tomwimmenhove/B133D01/base.kicad_pcb

## KiCad design base.kicad_pcb (2019-05-05)

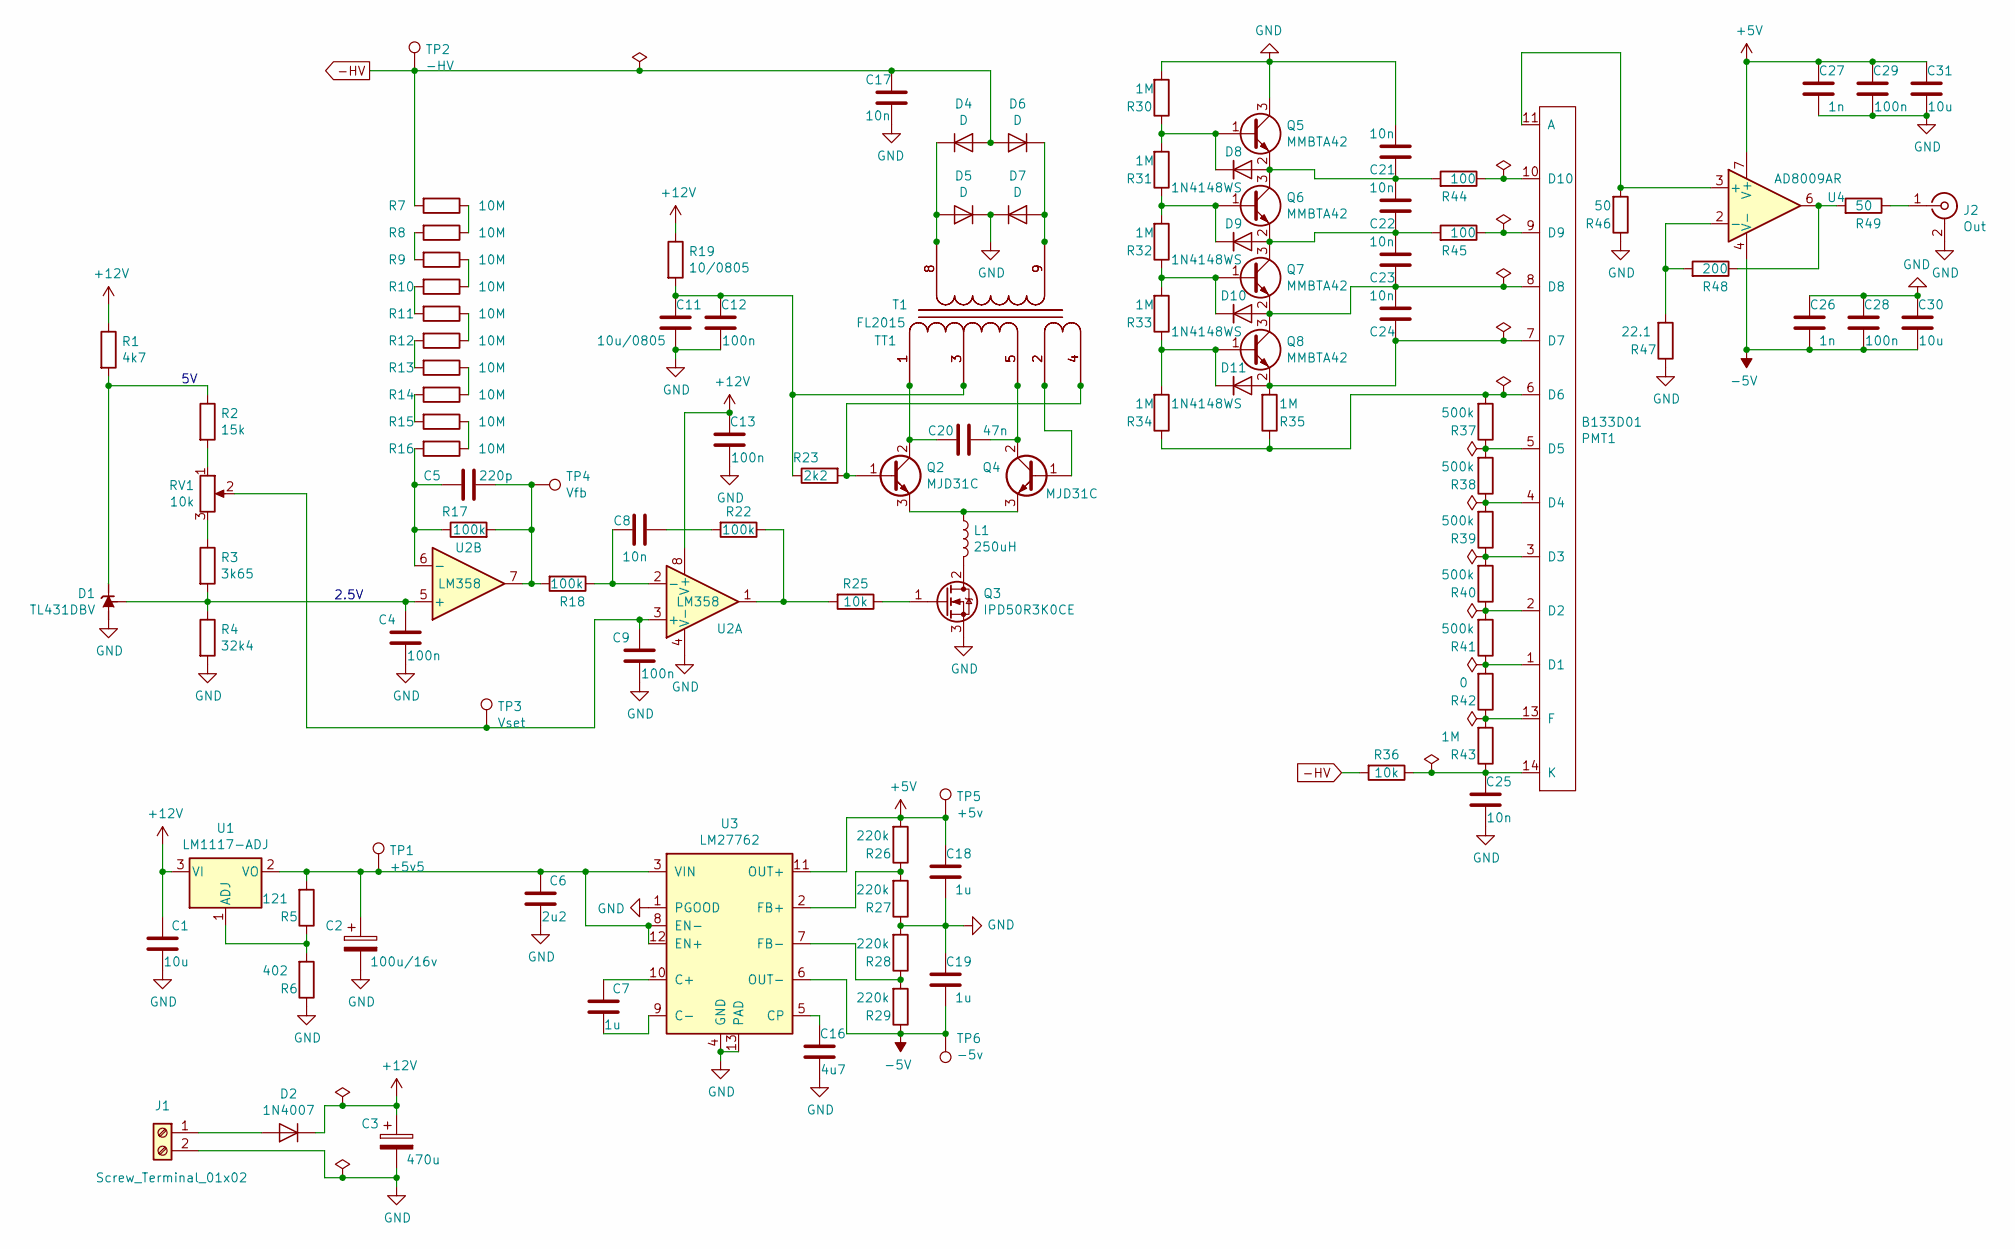
[picture p1: schematic base.sch]

Parts:
C1: 10u; C_0805_2012Metric
C2: 100u/16v; CP_EIA-7343-30_AVX-N
C3: 470u; CP_EIA-7360-38_Kemet-E
C4, C9, C12, C13, C28, C29: 100n; C_0603_1608Metric
C5: 220p; C_0603_1608Metric
C6: 2u2; C_0603_1608Metric
C7, C18, C19: 1u; C_0603_1608Metric
C8: 10n; C_0603_1608Metric
C11: 10u/0805; C_0805_2012Metric
C16: 4u7; C_0603_1608Metric
C17, C25: 10n; C_Disc_D10.5mm_W5.0mm_P7.50mm
C20: 47n; C_Rect_L7.2mm_W3.5mm_P5.00mm_FKS2_FKP2_MKS2_MKP2
C21, C22, C23, C24: 10n; C_0805_2012Metric
C26, C27: 1n; C_0603_1608Metric
C30, C31: 10u; C_0603_1608Metric
D1: TL431DBV; SOT-23-5
D2: 1N4007; D_SMB
D4, D5, D6, D7: D; D_A-405_P12.70mm_Horizontal
D8, D9, D10, D11: 1N4148WS; D_SOD-323
J1: Screw_Terminal_01x02; TerminalBlock_4Ucon_1x02_P3.50mm_Horizontal
J2: Out; SMA_Amphenol_132291-12_Vertical
L1: 250uH; L_Taiyo-Yuden_NR-80xx
PMT1: B133D01
Q2, Q4: MJD31C; TO-252-2
Q3: IPD50R3K0CE; TO-252-2
Q5, Q6, Q7, Q8: MMBTA42; SOT-23
R1: 4k7; R_0603_1608Metric
R2: 15k; R_0603_1608Metric
R3: 3k65; R_0603_1608Metric
R4: 32k4; R_0603_1608Metric
R5: 121; R_0603_1608Metric
R6: 402; R_0603_1608Metric
R7, R8, R9, R10, R11, R12, R13, R14, R15, R16: 10M; R_0805_2012Metric
R17, R18, R22: 100k; R_0603_1608Metric
R19: 10/0805; R_0805_2012Metric
R23: 2k2; R_0805_2012Metric
R25: 10k; R_0603_1608Metric
R26, R27, R28, R29: 220k; R_0603_1608Metric
R30, R31, R32, R33, R34, R35: 1M; R_0805_2012Metric
R36: 10k; R_0805_2012Metric
R37, R38, R39, R40, R41: 500k; R_0805_2012Metric
R42: 0; R_0603_1608Metric
R43: 1M; R_1206_3216Metric
R44, R45: 100; R_0603_1608Metric
R46: 50; R_0603_1608Metric
R47: 22.1; R_0603_1608Metric
R48: 200; R_0603_1608Metric
R49: 50; R_0805_2012Metric
RV1: 10k; Potentiometer_Bourns_3314J_Vertical
T1: FL2015; FL2015-4LB
TP1: +5v5; TestPoint_Pad_D1.5mm
TP2: -HV; TestPoint_Pad_D1.5mm
TP3: Vset; TestPoint_Pad_D1.5mm
TP4: Vfb; TestPoint_Pad_D1.5mm
TP5: +5v; TestPoint_Pad_D1.5mm
TP6: -5v; TestPoint_Pad_D1.5mm
TT1: FL2015; G23736
U1: LM1117-ADJ; SOT-223-3_TabPin2
U2: LM358; SOIC-8_3.9x4.9mm_P1.27mm
U3: LM27762; WSON-12-1EP_3x2mm_P0.5mm_EP1x2.65_ThermalVias
U4: AD8009AR; SOIC-8_3.9x4.9mm_P1.27mm

Connections:
+5V: C18.1, C27.1, C29.1, C31.1, R26.2, TP5.1, U3.11 (OUT+), U4.7 (V+)
+12V: C1.1, C3.1, C13.1, D2.1 (K), R1.1, R19.1, U1.3 (VI), U2.8 (V+)
-5V: C19.2, C26.2, C28.2, C30.2, R29.1, TP6.1, U3.6 (OUT-), U4.4 (V-)
-HV: C17.1, D4.2 (A), D6.2 (A), R7.2, R36.2, TP2.1
GND: C1.2, C2.2, C3.2, C4.2, C6.2, C9.2, C11.2, C12.2, C13.2, C16.2, C17.2, C18.2, C19.1, C21.2, C25.2, C26.1, C27.2, C28.1, C29.2, C30.1, C31.2, D1.5 (A), D5.1 (K), D7.1 (K), J1.2, J2.2 (Ext), Q3.3 (S), Q5.3 (C), R4.2, R6.1, R27.1, R28.2, R30.2, R46.1, R47.1, U2.4 (V-), U3.1 (PGOOD), U3.4 (GND), U3.13 (PAD)
unnamed: C2.1, C6.1, R5.2, TP1.1, U1.2 (VO), U3.3 (VIN), U3.8 (EN-), U3.12 (EN+)
unnamed: C4.1, D1.4 (REF), R3.2, R4.1, U2.5 (+)
unnamed: C5.1, R16.2, R17.1, U2.6 (-)
unnamed: C5.2, R17.2, R18.2, TP4.1, U2.7
unnamed: C7.1, U3.10 (C+)
unnamed: C7.2, U3.9 (C-)
unnamed: C8.1, R22.2
unnamed: C8.2, R18.1, U2.2 (-)
unnamed: C9.1, RV1.2, TP3.1, U2.3 (+)
unnamed: C11.1, C12.1, R19.2, R23.1, T1.3, TT1.3
unnamed: C16.1, U3.5 (CP)
unnamed: C20.1, Q2.2 (C), T1.1, TT1.1
unnamed: C20.2, Q4.2 (C), T1.5, TT1.5
unnamed: C21.1, C22.2, D8.2 (A), Q5.2 (E), Q6.3 (C), R44.2
unnamed: C22.1, C23.2, D9.2 (A), Q6.2 (E), Q7.3 (C), R45.2
unnamed: C23.1, C24.2, D10.2 (A), PMT1.8 (D8), Q7.2 (E), Q8.3 (C)
unnamed: C24.1, D11.2 (A), PMT1.7 (D7), Q8.2 (E), R35.2
unnamed: C25.1, PMT1.14 (K), R36.1, R43.1
unnamed: D1.3 (K), R1.2, R2.1
unnamed: D2.2 (A), J1.1
unnamed: D4.1 (K), D5.2 (A), T1.8, TT1.8
unnamed: D6.1 (K), D7.2 (A), T1.9, TT1.9
unnamed: D8.1 (K), Q5.1 (B), R30.1, R31.2
unnamed: D9.1 (K), Q6.1 (B), R31.1, R32.2
unnamed: D10.1 (K), Q7.1 (B), R32.1, R33.2
unnamed: D11.1 (K), Q8.1 (B), R33.1, R34.2
unnamed: J2.1 (In), R49.1
unnamed 32: L1.1, Q2.3 (E), Q4.3 (E); also elsewhere on the board
unnamed 33: L1.2, Q3.2 (D); also elsewhere on the board
unnamed: PMT1.1 (D1), R41.1, R42.2
unnamed: PMT1.2 (D2), R40.1, R41.2
unnamed: PMT1.3 (D3), R39.1, R40.2
unnamed: PMT1.4 (D4), R38.1, R39.2
unnamed: PMT1.5 (D5), R37.1, R38.2
unnamed: PMT1.6 (D6), R34.1, R35.1, R37.2
unnamed: PMT1.9 (D9), R45.1
unnamed: PMT1.10 (D10), R44.1
unnamed: PMT1.11 (A), R46.2, U4.3 (+)
unnamed: PMT1.13 (F), R42.1, R43.2
unnamed: Q2.1 (B), R23.2, T1.4, TT1.4
unnamed: Q3.1 (G), R25.1
unnamed: Q4.1 (B), T1.2, TT1.2
unnamed: R2.2, RV1.1
unnamed: R3.1, RV1.3
unnamed: R5.1, R6.2, U1.1 (ADJ)
unnamed: R7.1, R8.1
unnamed: R8.2, R9.2
unnamed: R9.1, R10.1
unnamed: R10.2, R11.2
unnamed: R11.1, R12.1
unnamed: R12.2, R13.2
unnamed: R13.1, R14.1
unnamed: R14.2, R15.2
unnamed: R15.1, R16.1
unnamed: R22.1, R25.2, U2.1
unnamed: R26.1, R27.2, U3.2 (FB+)
unnamed: R28.1, R29.2, U3.7 (FB-)
unnamed: R47.2, R48.2, U4.2 (-)
unnamed: R48.1, R49.2, U4.6

Notes on the sheet:
2.5V

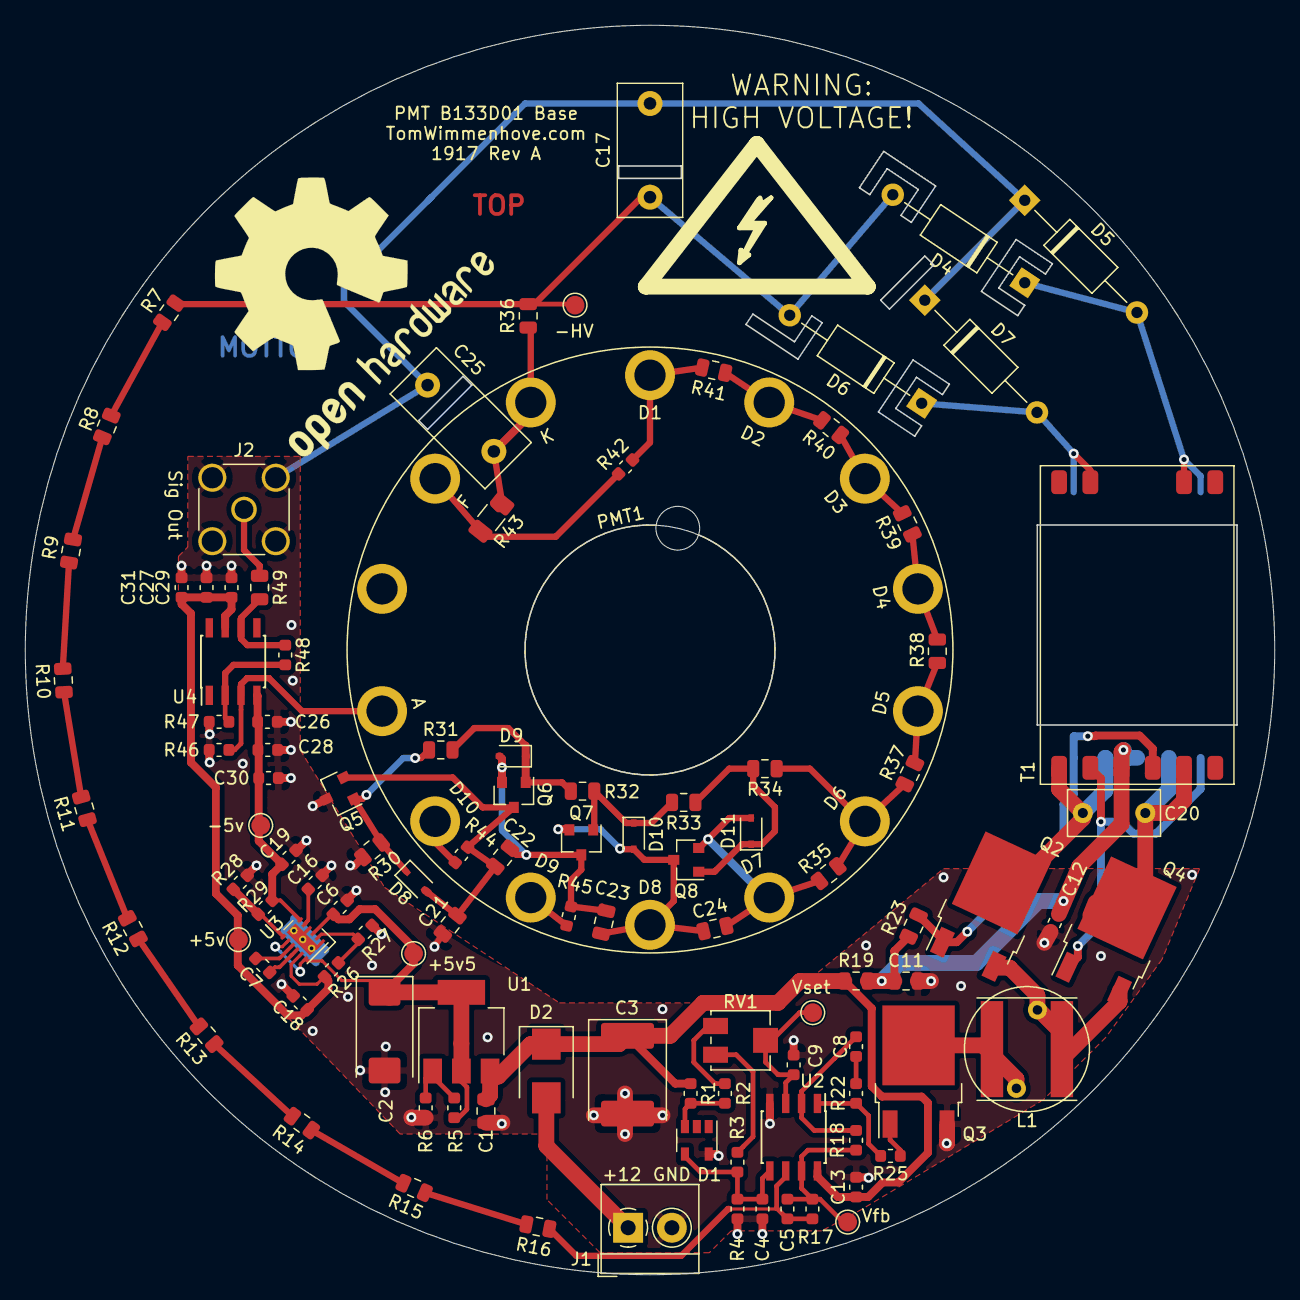
[picture p2: board base.kicad_pcb from above]

Board: 2 copper layers, 100.0 x 100.0 mm, 117 parts (0 on the bottom side), 64 nets.

Other parts of the board:
HV1: Symbol_Highvoltage_Type2_SilkScreenTop_Small
L**: L
Slot**: ISlot
Slot**#2, Slot**#6: ISlot
Slot**#3, Slot**#4, Slot**#7: CSlot
Slot**#5: LSlot

Their connections:
unnamed 32: L**.1; also elsewhere on the board
unnamed 33: L**.2; also elsewhere on the board
