tomwimmenhove/B133D01/(commit log)

2019-04-24 Added optional G23736 (electronic goldmine) footprint
    [base.kicad_pcb, base.sch]
2019-04-27 More routing. Removed excessive ripper remover
    [base.kicad_pcb, base.sch]
2019-04-27 Accidentally used PNP bjt's for royer drivers
    [base.sch]
2019-04-27 Moved stuff around. Added isolation slots.
    [base.kicad_pcb, base.sch]
2019-04-27 Fixed PMT hole size
    [base.kicad_pcb]
2019-04-28 Added testpoints
    [base.kicad_pcb, base.sch]
2019-04-28 Added transformer 3d model
    [base.kicad_pcb, base.sch]
2019-04-28 Library name juggling
    [base.kicad_pcb, base.sch]
2019-04-28 Fixed undriven pins errors in DRC
    [base.sch]
2019-04-28 moved files around. Changed cutout for alternative transformer package
    [base.kicad_pcb, base.sch]
2019-04-28 Fixed DRC
    [base.kicad_pcb]
2019-04-28 Minor fixes
    [base.kicad_pcb]
2019-05-04 Changed royer circuit cap to TH
    [base.kicad_pcb, base.sch]
2019-05-04 Fixed some footprints and values
    [base.kicad_pcb, base.sch]
2019-05-04 Added slots foot prints
    [base.kicad_pcb]
2019-05-04 Small fix
    [base.kicad_pcb]
2019-05-05 Layout changes
    [base.kicad_pcb]
2019-05-05 Added alternative L
    [base.kicad_pcb]
